wolfgangfriedrich/P42-Pico_Video4/Frames/NTSC320x200/Wallace+Gromit_256.bmp

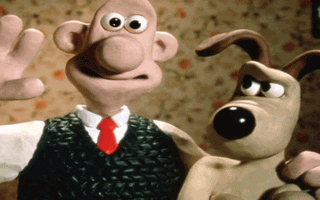
Frames/NTSC320x200/Wallace+Gromit_256.bmp
