wolfgangfriedrich/P42-Pico_Video4/Frames/300x200/Wallace+Grommit_256.bmp

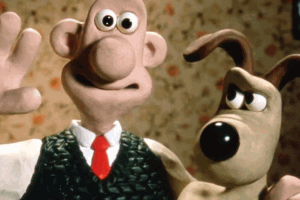
Frames/300x200/Wallace+Grommit_256.bmp
