wolfgangfriedrich/P42-Pico_Video4/Frames/NTSC320x200/F1_320x200.bmp

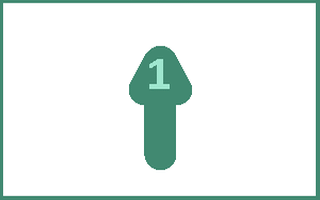
Frames/NTSC320x200/F1_320x200.bmp
