wolfgangfriedrich/P42-Pico_Video4/Frames/PAL300x240/gruenrotblau-frame_256.bmp

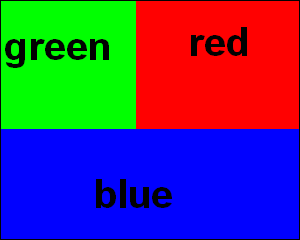
Frames/PAL300x240/gruenrotblau-frame_256.bmp
