wolfgangfriedrich/P42-Pico_Video4/Step by step instruction image download.pdf

Caution, all commands in the serial console work without pressing the enter key. My command parser is indeed very basic.

### Step by step instruction

to download an image with colour conversion to the board

### Preparation:

TeraTerm4 download
https://github.com/TeraTermProject/teraterm/releases/download/v4.108/teraterm-4.108.exe

Pico_Video4 Arduino sketch
Installed on the P42-Pico-Video4 board:

https://github.com/wolfgangfriedrich/P42-Pico_Video4/tree/main/Code/P42-Pico_Video4

Image to download shall exist as .BMP with 256 colour palette (8 bits per pixel) and size not larger than the resolution.

Teraterm4 connected to UART exposed from the Video4 board. In this example it is COM7, 19200baud, 8N1

### Procedure

Serial console after boot should look like this.

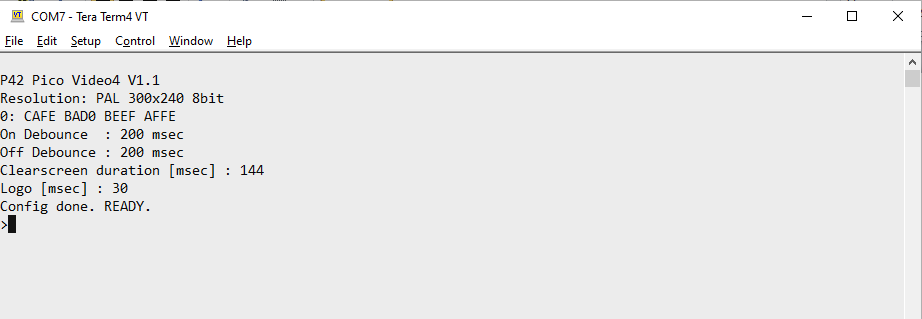
[picture p22: figure]

To download the image into screen buffer #7 press ‘i’ and then ‘7’.

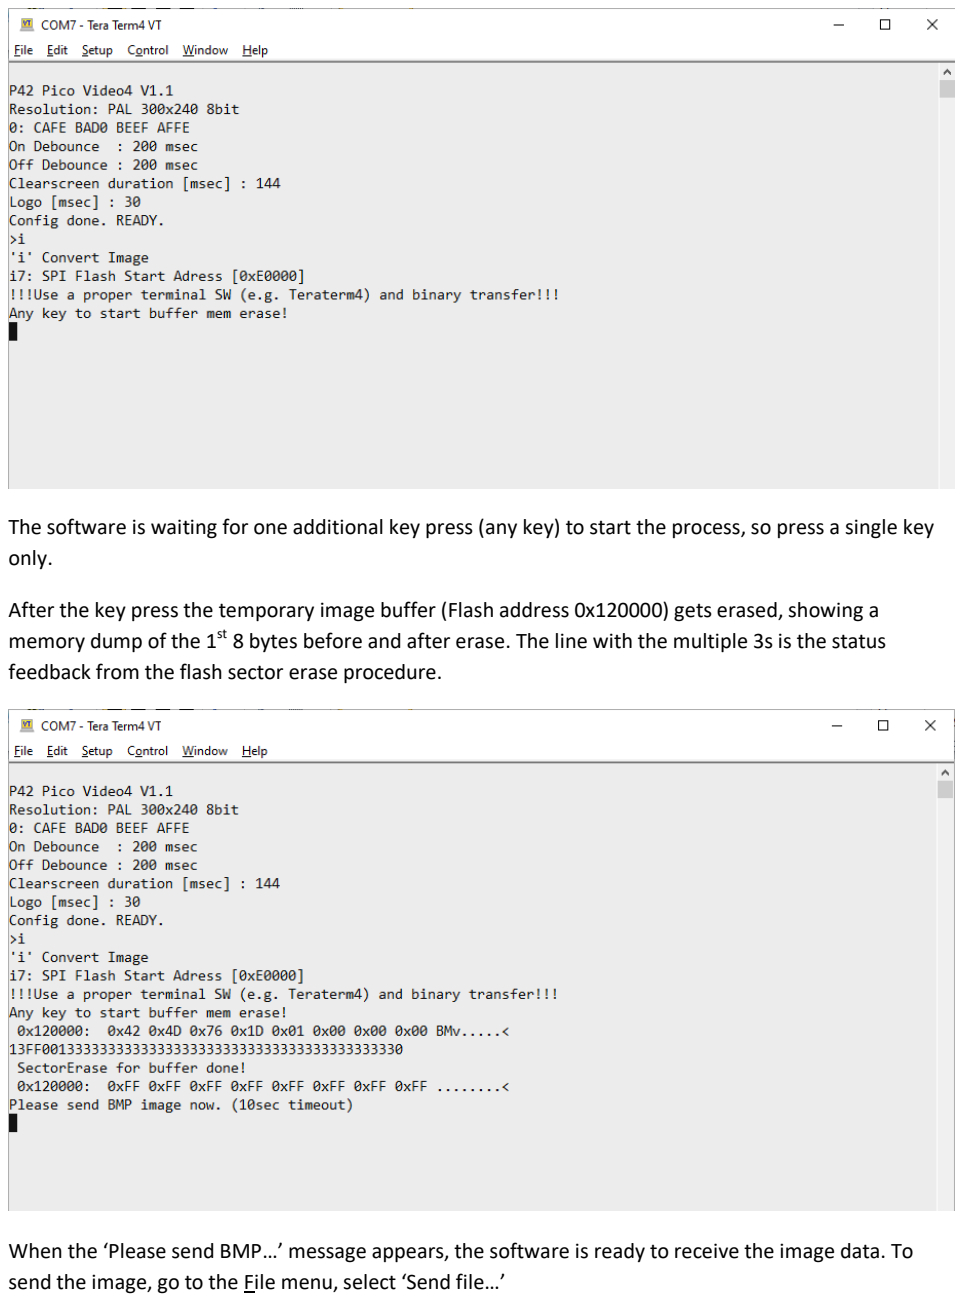
[picture p23: page 2]

The software is waiting for one additional key press (any key) to start the process, so press a single key only.

After the key press the temporary image buffer (Flash address 0x120000) gets erased, showing a memory dump of the 1st 8 bytes before and after erase. The line with the multiple 3s is the status feedback from the flash sector erase procedure.

When the ‘Please send BMP…’ message appears, the software is ready to receive the image data. To send the image, go to the File menu, select ‘Send file…’

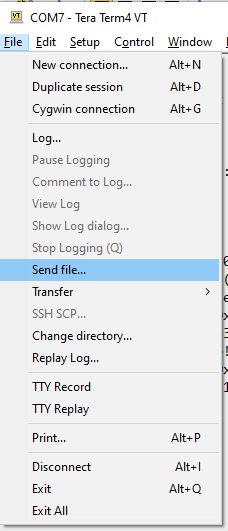
[picture p24: figure]

Important!!! First select Option Binary | and then navigate to the .BMP file for download and
select it. Click Open. BTW, the 10 second timeout does not really apply, it was an Arduino serial port option, but does not kick in.

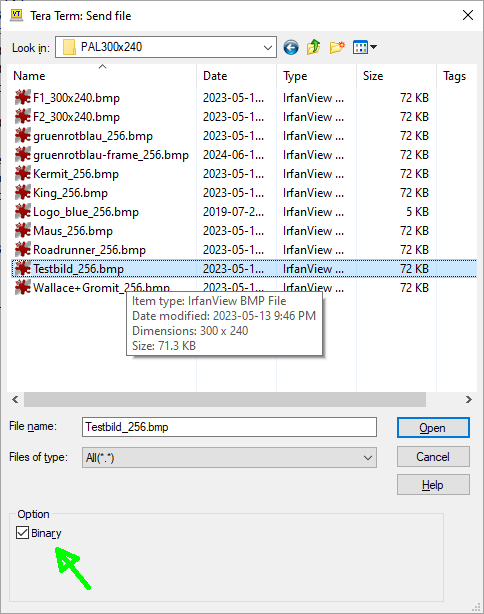
[picture p25: figure]

A Teraterm download window appears, showing the progress of the data transfer.

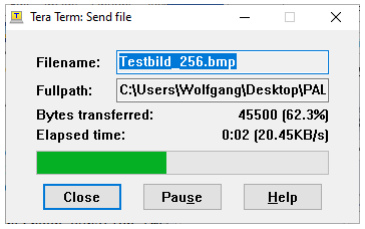
[picture p26: figure]

After the window closes, more memory dump and image byte messages show up in the terminal. Those messages are mostly used during development and debug, but might be helpful with problem solving.

The status messages should look similar to this:

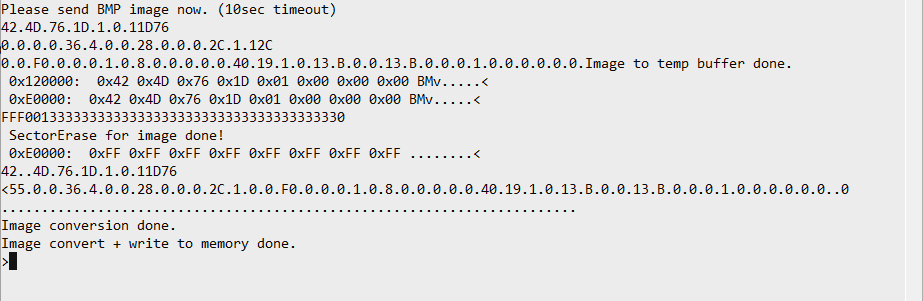
[picture p27: figure]

The image download should be done now. If a monitor is connected, the command ‘s7’ should bring the image to the display. Change the number if the download went into a different buffer.

My video capture card, running in the Win10 Camera app, would show this image and there would be a status message in the serial console:

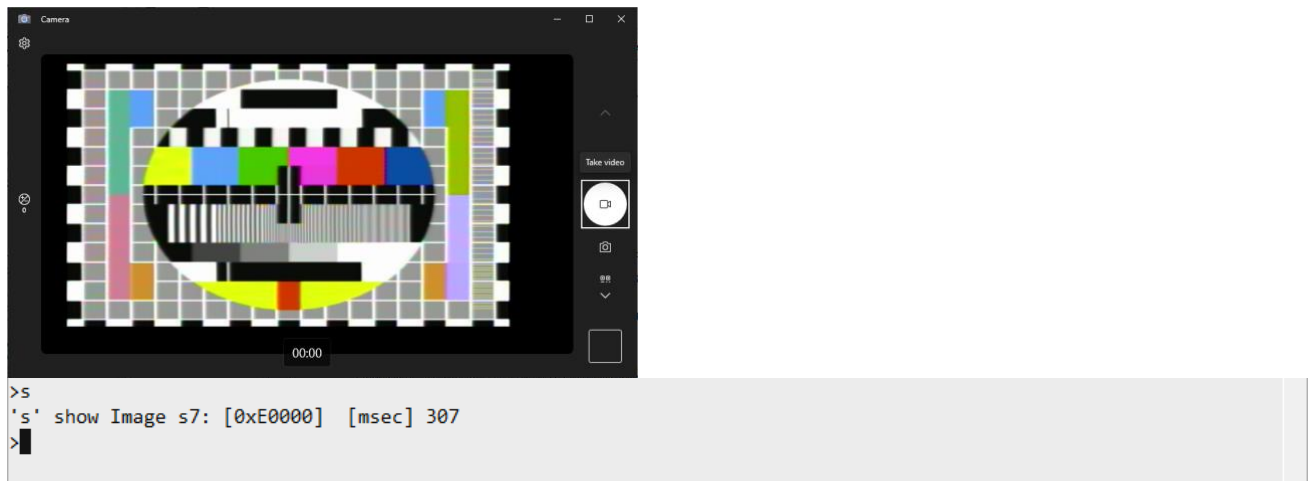
[picture p28: figure]

EoF.
