wolfgangfriedrich/P42-Pico_Video4/Design/rev1/ASSY P42-Pico_Video4 rev1.pdf

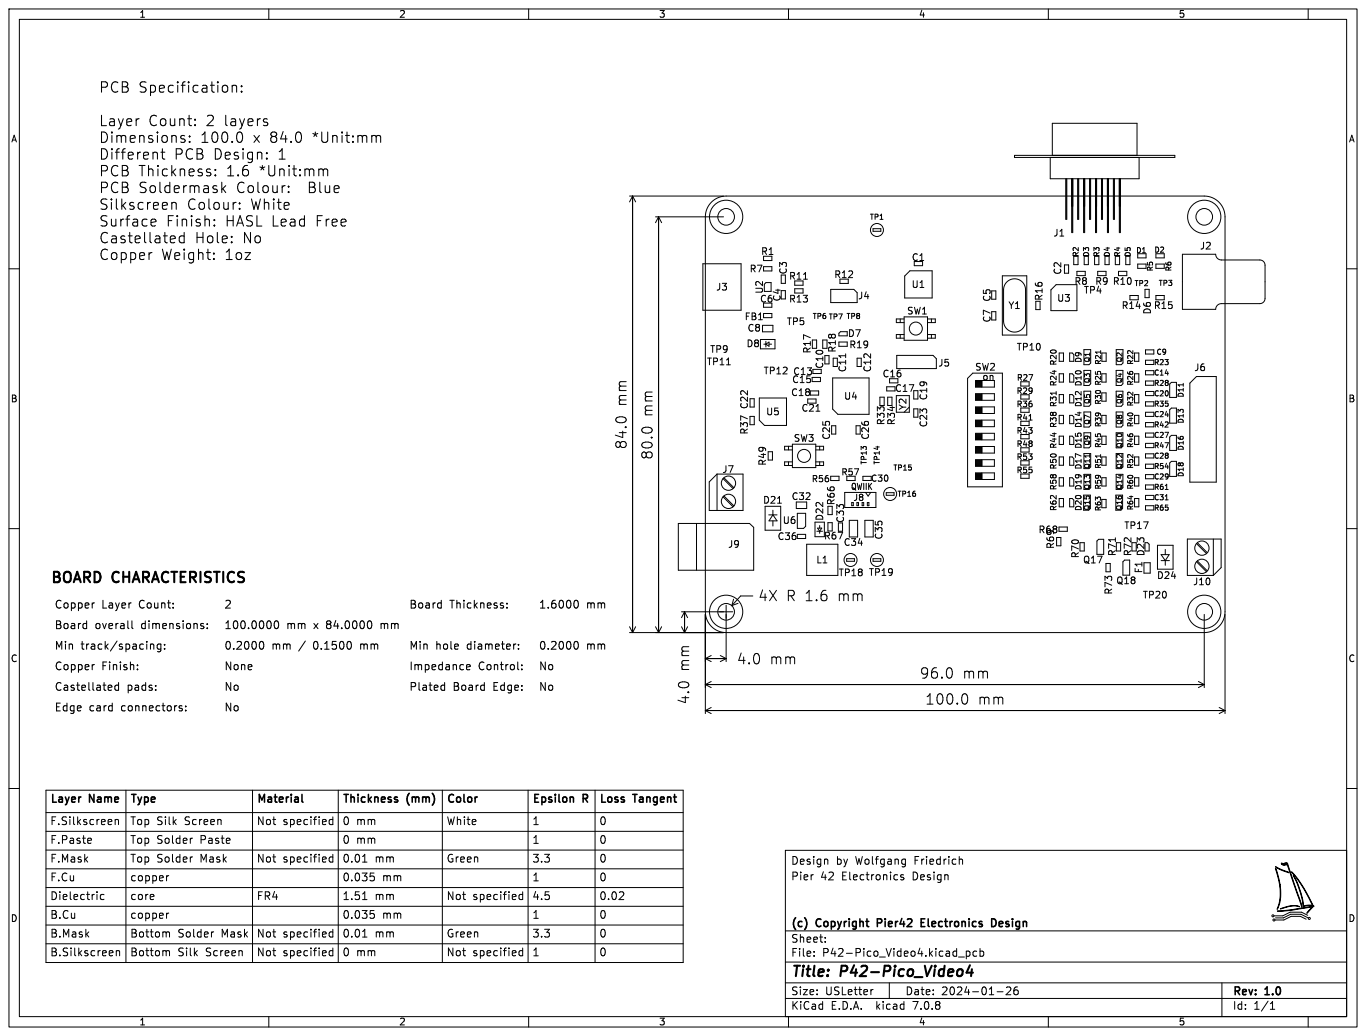
[picture p35: page 1]

Layer Count: 2 layers
PCB Thickness: 1.6 *Unit:mm
Surface Finish: HASL Lead Free
Copper Weight: 1oz

1 Green Not specified Green White Color 0 mm
