wolfgangfriedrich/P42-Pico_Video4/Code/P42-Pico_Video4/ImageFlashWrite.h

// ImageFlashWrite header file
// (c) Pier42 Electronics Design
//     https://www.tindie.com/stores/pier42/

// written by
// Wolfgang Friedrich
// Rev Start 2023/April/01
// Last change: 2023/April/01

#ifndef ImageFlashWrite_h
#define ImageFlashWrite_h

// Palette for VS23D040 standard display in BMP format
// B,   G,   R, 0
const byte ba_VS23S040_Palette[] = {
   0,   0,   0, 0,
  16,  16,  16, 0,
  32,  32,  32, 0,
  48,  48,  48, 0,
  64,  64,  64, 0,
  80,  80,  80, 0,
  96,  96,  96, 0,
 112, 112, 112, 0,
 143, 143, 143, 0,
 159, 159, 159, 0,
 175, 175, 175, 0,
 191, 191, 191, 0,
 207, 207, 207, 0,
 223, 223, 223, 0,
 239, 239, 239, 0,
 255, 255, 255, 0,
   0,  24,   0, 0,
  16,  40,   0, 0,
  32,  56,   0, 0,
  48,  72,   0, 0,
  64,  88,  16, 0,
  80, 104,  32, 0,
  96, 120,  48, 0,
 112, 136,  64, 0,
 143, 167,  95, 0,
 159, 183, 111, 0,
 175, 199, 127, 0,
 191, 215, 143, 0,
 207, 231, 159, 0,
 223, 247, 175, 0,
 239, 255, 191, 0,
 255, 255, 207, 0,
   0,   0,  96, 0,
  16,   0, 112, 0,
  32,   0, 128, 0,
  48,   0, 144, 0,
  64,  14, 160, 0,
  80,  30, 176, 0,
  96,  46, 192, 0,
 112,  62, 208, 0,
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

void f_SPImemdump (unsigned long address, unsigned int bytes);
void f_DownloadImage ( unsigned long memory_location );
void f_DownloadConvertImage ( unsigned long memory_location );
void SPImemSectorErase ( unsigned long mem_addr );

#endif
