wolfgangfriedrich/P42-Pico_Video4/(commit log)

2024-07-19 1st data commit
    Add Arduino code
    Add schematic + assembly drawing
    Add frames
    Add documentation
2024-07-19 Comments in code
    Fixed link to github repository in main .ino Arduino project files
    [P42-Pico_Demo.ino, P42-Pico_Video4.ino, VS23S040D.h]
2025-07-14 Documentation update
    Added Decu V1.1, image download instructions, interactive BOM
    [BOM P42-Video4_rev2.csv]
2026-01-18 Rev 2.0
    New version of the board, only minor changes.
    - 16 pin header room for shrouded version
    - QWIIC pinout fixed
    [VS23S040D.h]
2026-01-18 Update P42 Pico Video4 Documentation V2.0.pdf
    Documentation formatting
2026-01-18 Update ibom.html
    Added interactive HTML BOM of rev2 to the repo.
